docvacuumtubes/K3NG-based-Arduino-Nano-Computer-Controllable-Rotator-Controller/front.JPG

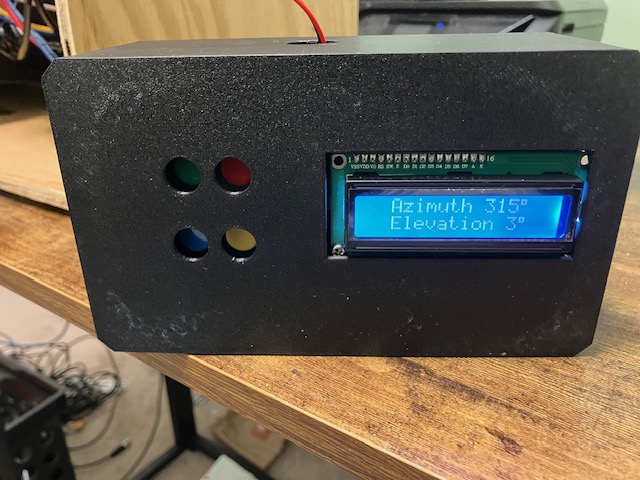
front.JPG
