docvacuumtubes/K3NG-based-Arduino-Nano-Computer-Controllable-Rotator-Controller/bottomside.JPG

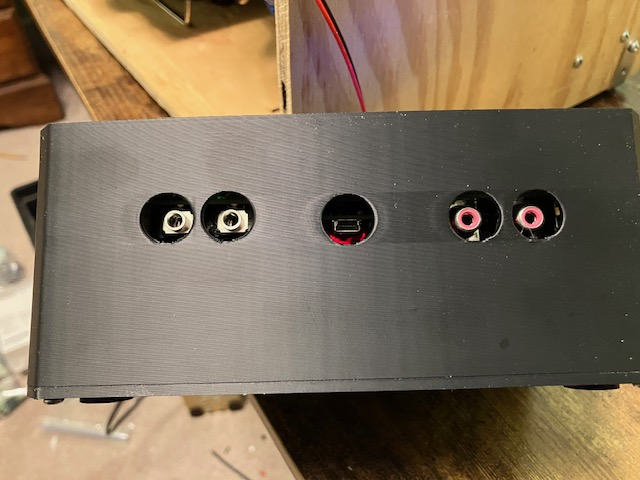
bottomside.JPG
