docvacuumtubes/K3NG-based-Arduino-Nano-Computer-Controllable-Rotator-Controller/bottomunflanged.JPG

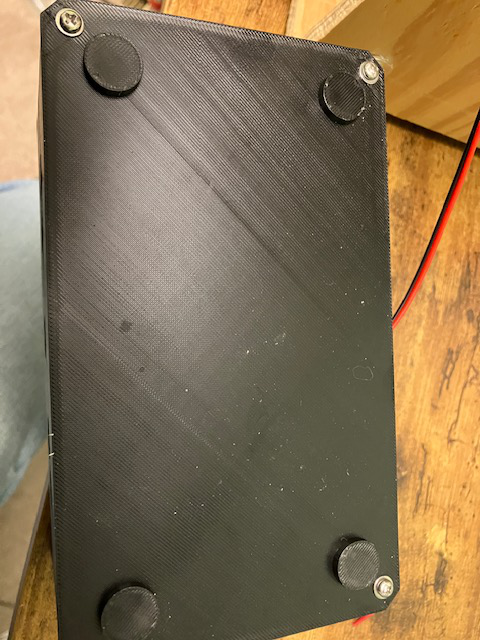
bottomunflanged.JPG
