docvacuumtubes/K3NG-based-Arduino-Nano-Computer-Controllable-Rotator-Controller/ImageofBoard.jpg

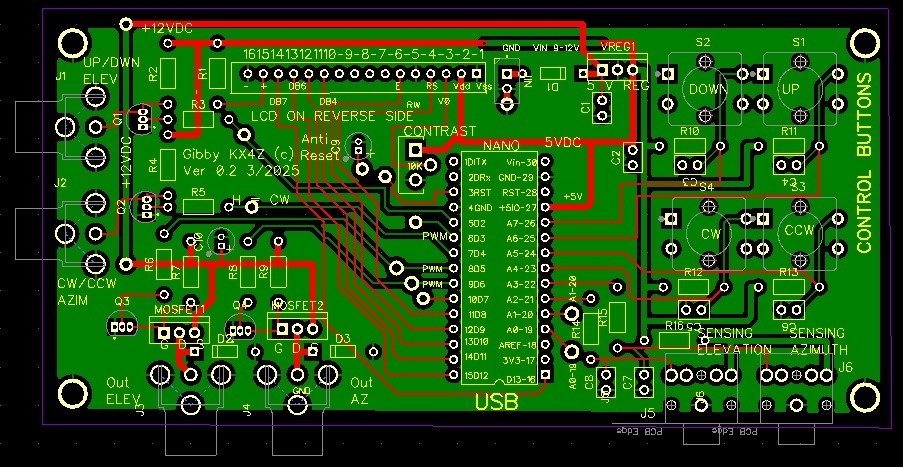
ImageofBoard.jpg
