docvacuumtubes/K3NG-based-Arduino-Nano-Computer-Controllable-Rotator-Controller/side.JPG

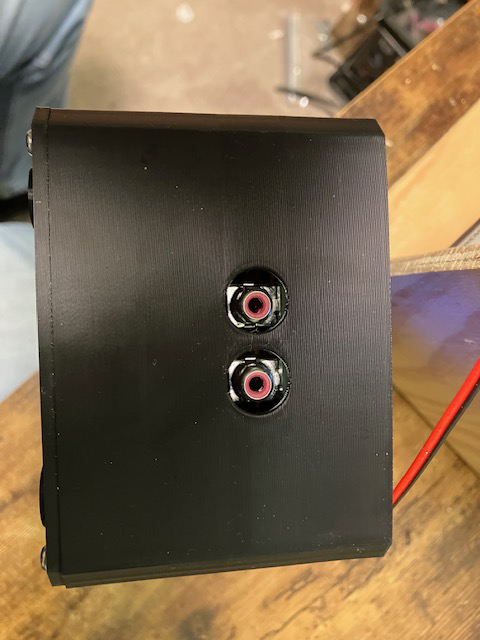
side.JPG
