docvacuumtubes/K3NG-based-Arduino-Nano-Computer-Controllable-Rotator-Controller/K3NG Rotator Dual Axis Controller Board.xlsx

 |  |  | xxxx xxxx xxxxx xxPCS BOM (Sample Bill of Materials)
Item # | *Designator | *Qty | Manufacturer | *Mfg Part # | Description / Value | *Package/Footprint | Type | Your Instructions / Notes | PCBWay Update
1 | U1 | 1 |  |  | Arduino Nano, 30-pin DIP package headers installed https://www.amazon.com/dp/B07G99NNXL?ref=ppx_yo2ov_dt_b_fed_asin_title |  |  | Purchase from Amazon
2 | U2 |  | Generic | Any LM7805 3 terminal likely to work | LM7805 5V 3terminal 1A regulator |  |  | Acceptable to use LM7805T https://item.szlcsc.com/8436622.html?fromZone=s_s__%2522LM7805%2522
5 | Q7, Q8 | 2 | Infineon Technologies | IRF4905 | P channel enhancement MOSFET, Vds >=50V, Rdson <=10milli-ohm IRF4905 may be used https://www.digikey.com/en/products/detail/infineon-technologies/IRF4905PBF/812139 |  |  | Substitutes are difficult. Consider: https://www.digikey.com/en/products/detail/goford-semiconductor/G040P04T/19524542
8 | Contrast |  | Generic |  | 10K trimmer potentiometer, 1/4 watt can use: https://www.amazon.com/dp/B0F1S6NP3N |  |  | Purchase from Amazon
14 | J1,J2,J3,J4 | 4 | SameSky | RCJ-012 | https://www.mouser.com/ProductDetail/Same-Sky/RCJ-012?qs=WyjlAZoYn53isKUFZudEAg%3D%3D |  |  | Mouser 490-RCJ-012
15 | J5,J6 | 2 | SameSky | SJ1-3545N | https://www.mouser.com/ProductDetail/Same-Sky/SJ1-3545N?qs=WyjlAZoYn53N5dGhOxE1Xw%3D%3D |  |  | Mouser 490-SJ1-3545N
16 | S1,S2,S3,S4 | 4 | GikFun | Gikfun 12x12x7.3 mm | Amazon https://www.amazon.com/dp/B01E38OS7K |  |  | From Amazon
17 | JIN,VREG1 |  | This are pads to solder wires to |  | These are just pads to solder power supply wires to
18 | C10 |  |  |  | All capacitors are 0.1 uf ceramic rated 25V or more
19 | Q1, Q2, Q3 | 3 | Generic | 2N3094 or 2N2222 | Generic 2N3904 or 2N2222
20 | R10, R11, R12, F13 |  | Generic | 10K ¼ Watt | Generic 10K ¼ Watt
21 | R16 | 1 | Generic | 47 ohm ½ watt | Generic 47 ohm ½ watt
22 | R3, R5 | 2 | Generic | 2K 1/4Watt | OK to use 1K if needed
23 | R2, R4, R7, R9,R14,R15 |  | Generic | 1K ¼ watt | Generic 1K ¼ W
24 | R1 | 1 | Generic | 200 ohm ½ watt | Adjust value to get brightness desired
25 | D1,D2,D3 | 3 | Generic | 1N4007 1A | OK to use any silicon diode rated for > 100V
Need a quick and accurante quote? Need an efficient production? Please read SMT Ordering Necessary Files & Info in 1 minute. Thank you very much! (https://www.pcbway.com/smt_ordering_guide.html)
Click for Instructions on How to Create a BOM (https://www.pcbway.com/blog/PCB_Assembly/How_to_Build_a_BOM__Bill_Of_Materials_.html)
