docvacuumtubes/K3NG-based-Arduino-Nano-Computer-Controllable-Rotator-Controller/K3NGRotatorBox2.stl

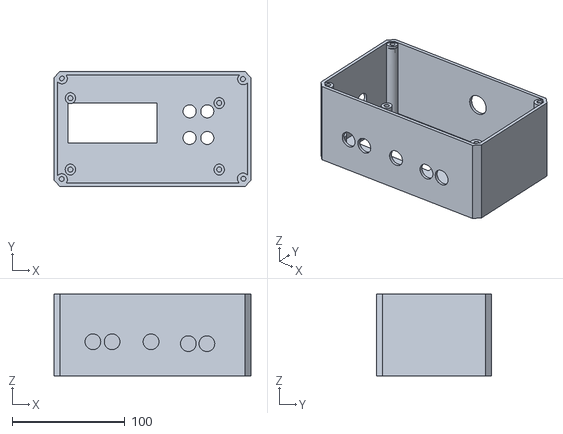
[picture p10: CAD file, 2026-03-20]
K3NGRotatorBox2.stl
175.0 x 102.5 x 72.5
