docvacuumtubes/K3NG-based-Arduino-Nano-Computer-Controllable-Rotator-Controller/(list of files, drawings)

Other design files:
K3NGController.dip
